MarkG98/LineFollower/(commit log)

2018-10-10 corrected order of if statement flow in Arduino code
    [lineFollower.ino]
2018-10-11 Collected more data
    [data1.csv]
2018-10-11 reorganizing repo
    [data.csv, data1.csv]
